jmcabaleiro/syringe-pumpV2/IMG_20181031_165427945.jpg

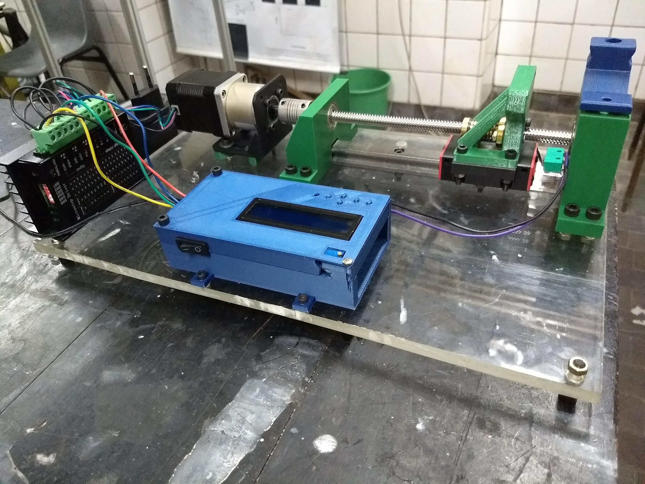
IMG_20181031_165427945.jpg
