jmcabaleiro/syringe-pumpV2/README.md

# syringe-pumpV2
Here you will find solid works parts and assembly to print in a fdm printer, along with the arduino software to control the pump. 
The software was developed by Dr. Eng. Emanuel Elizalde.
