jmcabaleiro/syringe-pumpV2/solid works parts and assembly/608-2Z.sldasm

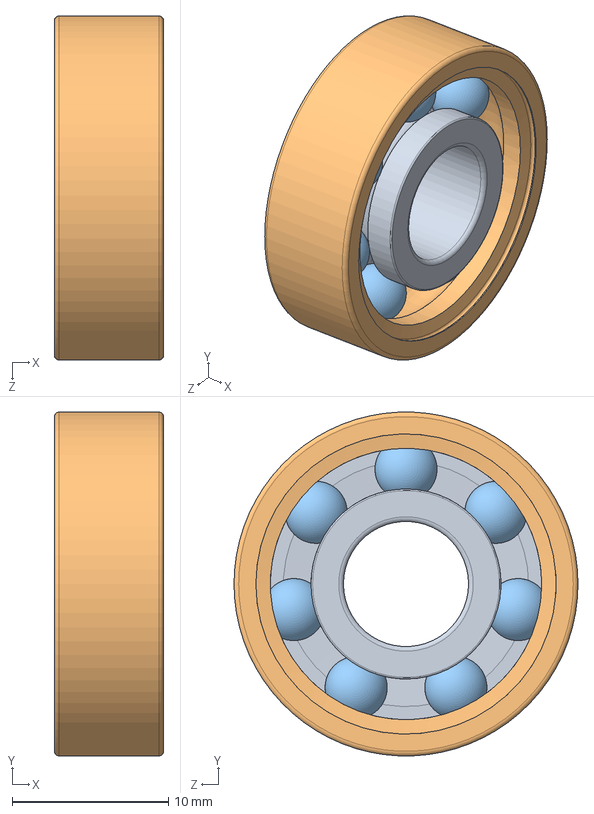
[picture p3: CAD file, 2019-08-21]
solid works parts and assembly/608-2Z.sldasm
7.00 x 22.0 x 22.0 mm
608-2Z_PART1
608-2Z_PART2
608-2Z_PART3 x 7
