jmcabaleiro/syringe-pumpV2/solid works parts and assembly/SW-case arduino syringe pump/arduinocaseTAPAC.SLDPRT

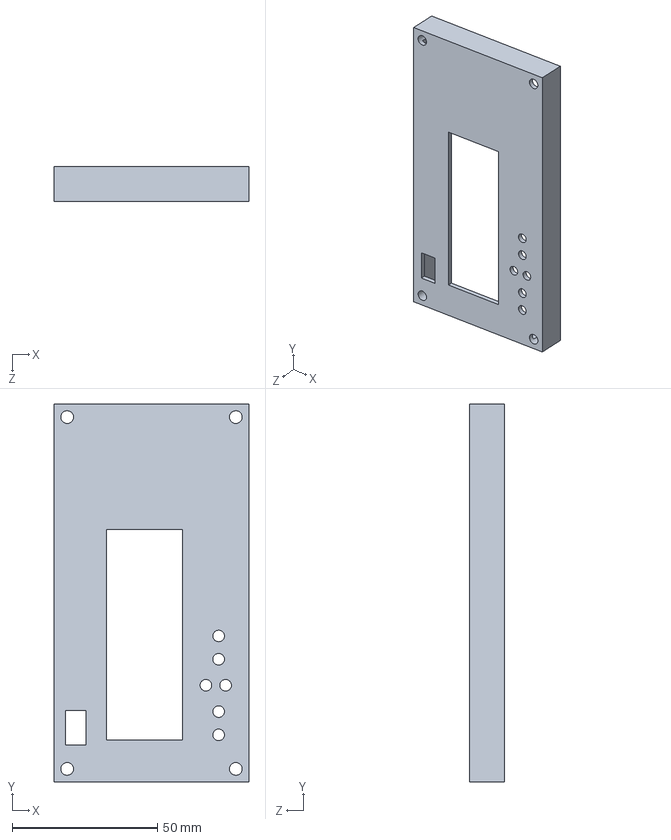
[picture p5: CAD file, 2019-08-21]
solid works parts and assembly/SW-case arduino syringe pump/arduinocaseTAPAC.SLDPRT
67.0 x 130.0 x 12.0 mm
