jmcabaleiro/syringe-pumpV2/solid works parts and assembly/Placa base.SLDPRT

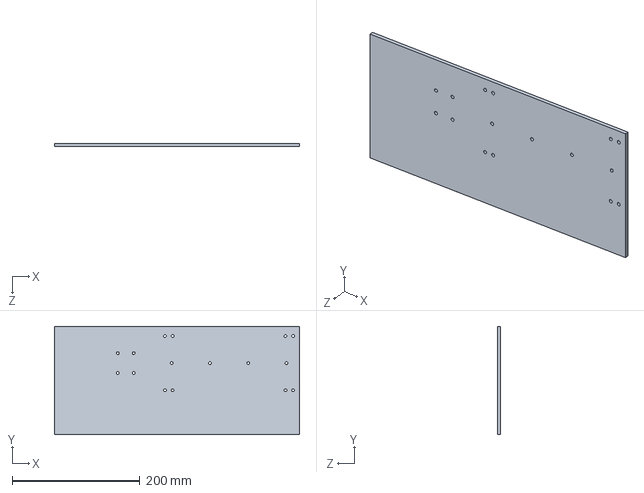
[picture p6: CAD file, 2019-08-21]
solid works parts and assembly/Placa base.SLDPRT
384.2 x 169.5 x 5.00 mm
