jmcabaleiro/syringe-pumpV2/solid works parts and assembly/SW-case arduino syringe pump/arduinocasebaseC.SLDPRT

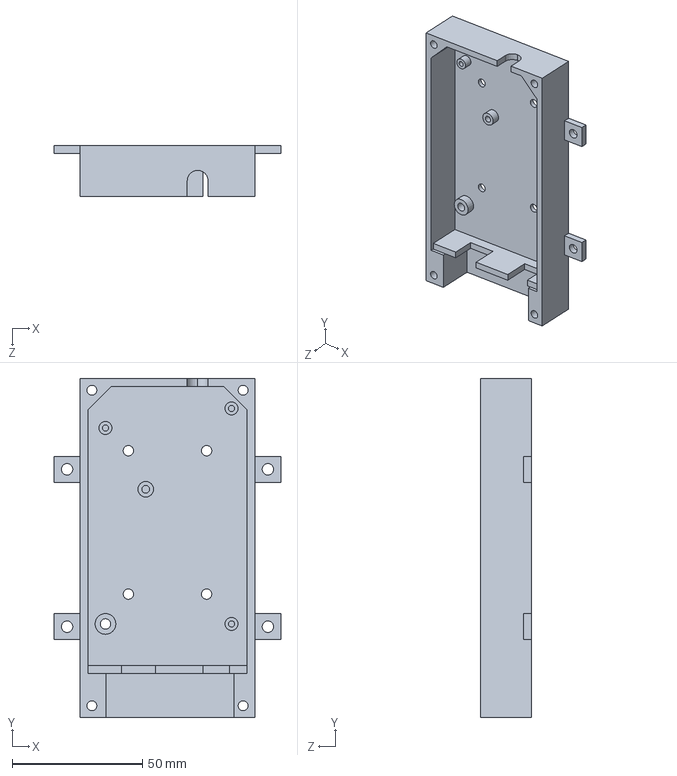
[picture p7: CAD file, 2019-08-21]
solid works parts and assembly/SW-case arduino syringe pump/arduinocasebaseC.SLDPRT
87.0 x 130.0 x 19.5 mm
