jmcabaleiro/syringe-pumpV2/solid works parts and assembly/SW-case arduino syringe pump/boton.SLDPRT

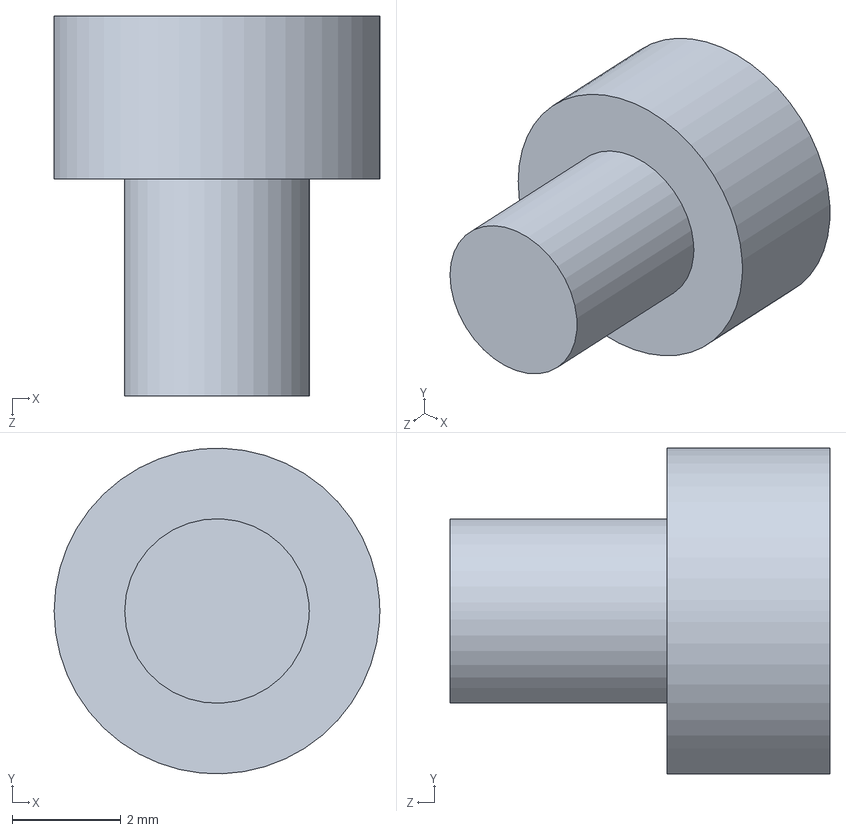
[picture p9: CAD file, 2019-08-21]
solid works parts and assembly/SW-case arduino syringe pump/boton.SLDPRT
6.00 x 6.00 x 7.00 mm
