jmcabaleiro/syringe-pumpV2/solid works parts and assembly/NEMA 17 Motor Mount Plate.SLDPRT

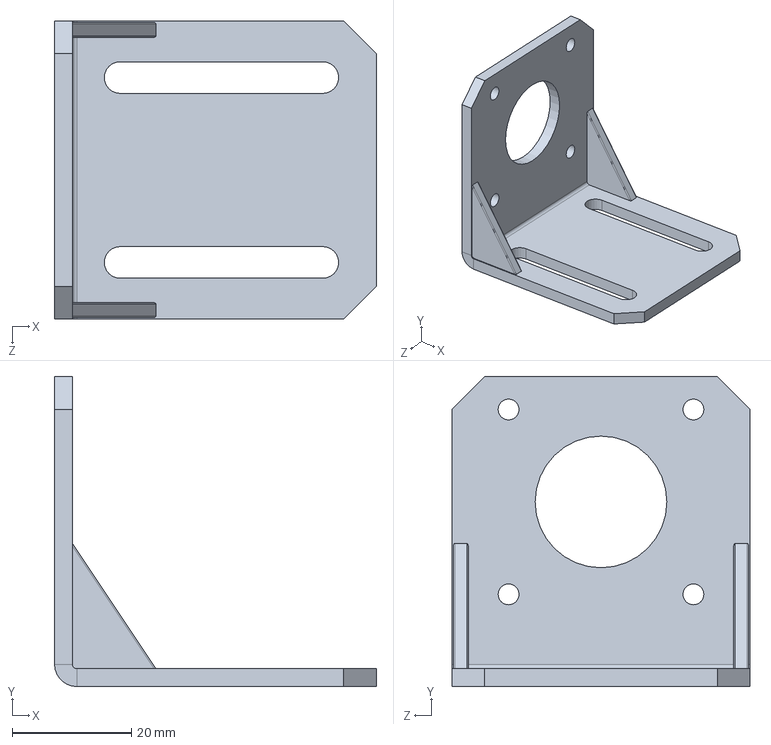
[picture p10: CAD file, 2019-08-21]
solid works parts and assembly/NEMA 17 Motor Mount Plate.SLDPRT
54.0 x 52.0 x 50.0 mm
