jmcabaleiro/syringe-pumpV2/solid works parts and assembly/NEMA17-PG27b.SLDPRT

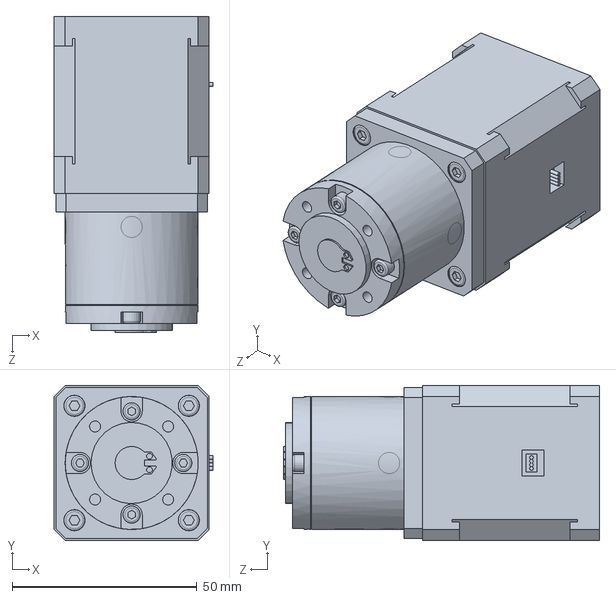
[picture p12: CAD file, 2019-08-21]
solid works parts and assembly/NEMA17-PG27b.SLDPRT
43.0 x 42.0 x 85.6 mm
