jmcabaleiro/syringe-pumpV2/solid works parts and assembly/soporte lado jeringa para impresion.SLDPRT

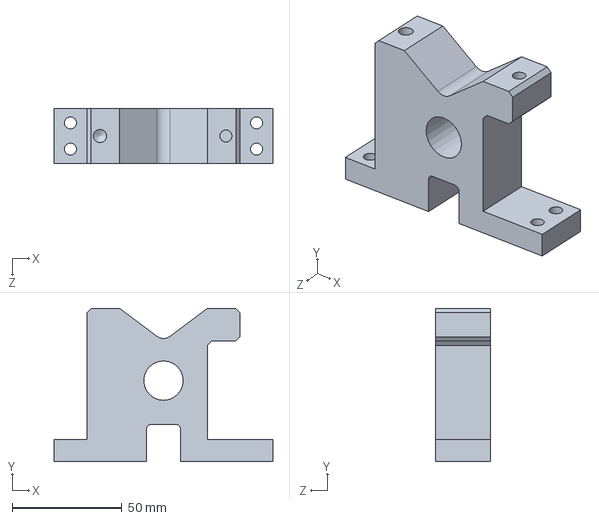
[picture p13: CAD file, 2019-08-21]
solid works parts and assembly/soporte lado jeringa para impresion.SLDPRT
100.0 x 70.0 x 25.0 mm
