jmcabaleiro/syringe-pumpV2/solid works parts and assembly/HGR15T-200mm.SLDPRT

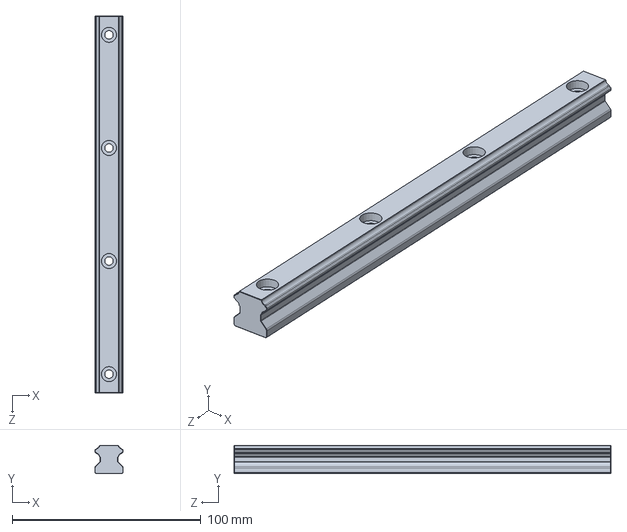
[picture p14: CAD file, 2019-08-21]
solid works parts and assembly/HGR15T-200mm.SLDPRT
15.0 x 15.0 x 200.0 mm
