jmcabaleiro/syringe-pumpV2/solid works parts and assembly/ejereductor.SLDPRT

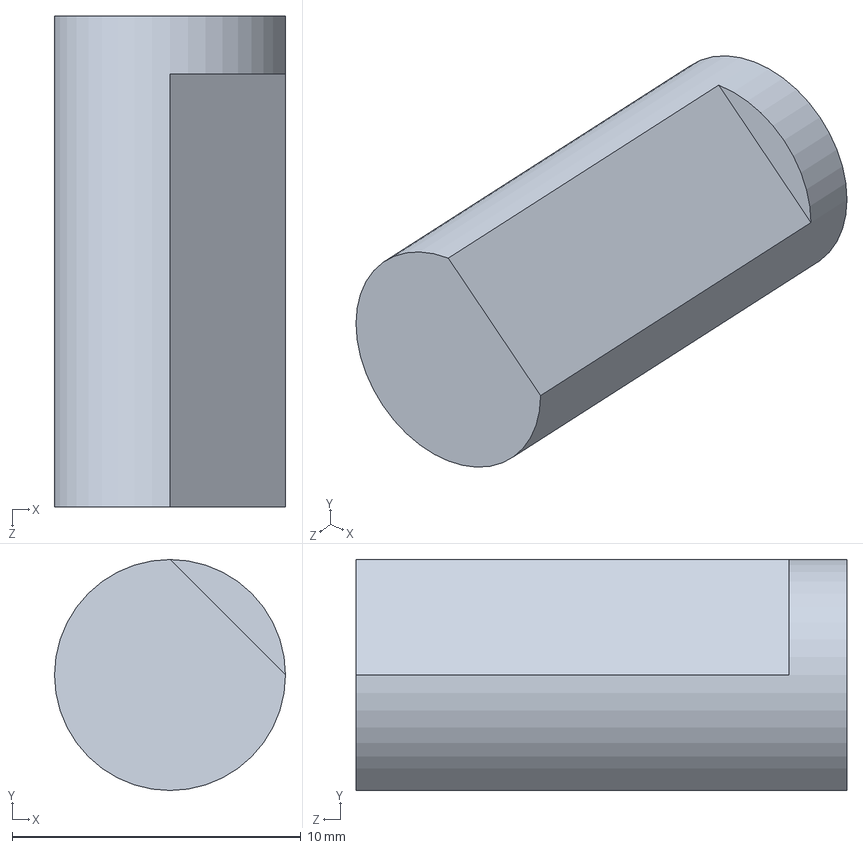
[picture p15: CAD file, 2019-08-21]
solid works parts and assembly/ejereductor.SLDPRT
8.00 x 8.00 x 17.0 mm
