jmcabaleiro/syringe-pumpV2/solid works parts and assembly/soporte lado motor para impresion.SLDPRT

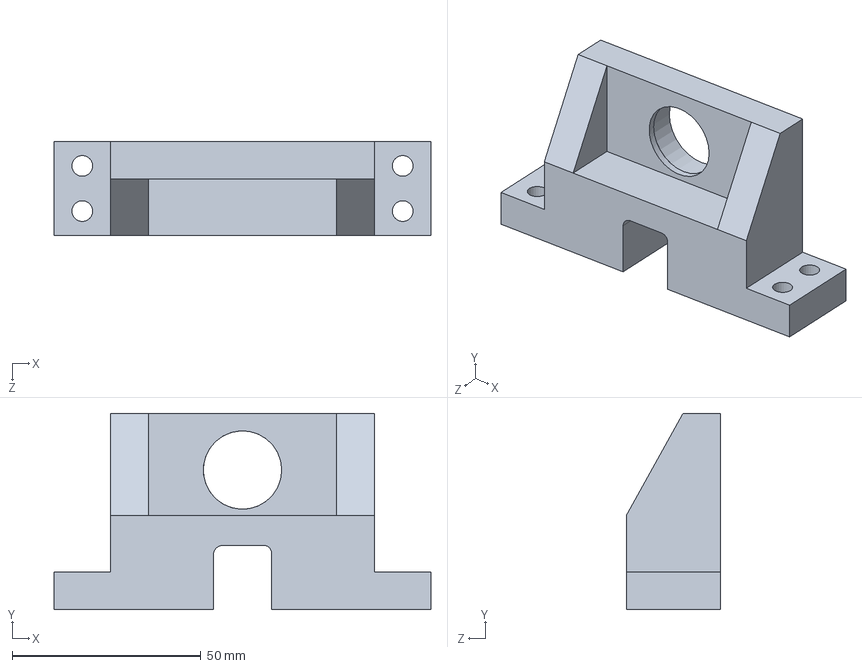
[picture p16: CAD file, 2019-08-21]
solid works parts and assembly/soporte lado motor para impresion.SLDPRT
100.0 x 52.0 x 25.0 mm
