jmcabaleiro/syringe-pumpV2/solid works parts and assembly/base soporte motor.SLDPRT

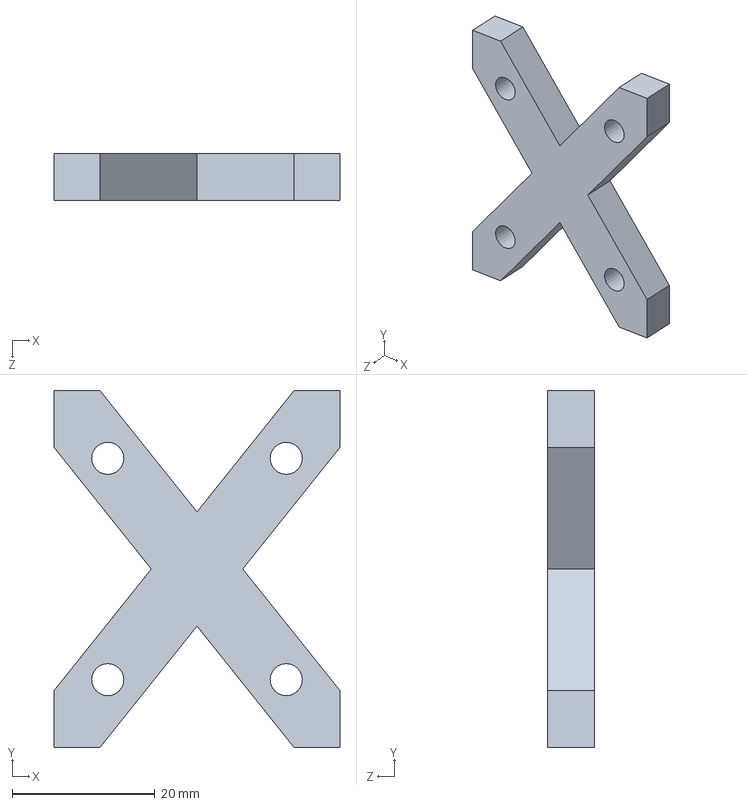
[picture p17: CAD file, 2019-08-21]
solid works parts and assembly/base soporte motor.SLDPRT
40.0 x 50.0 x 6.54 mm
