jmcabaleiro/syringe-pumpV2/solid works parts and assembly/trabajeringa.SLDPRT

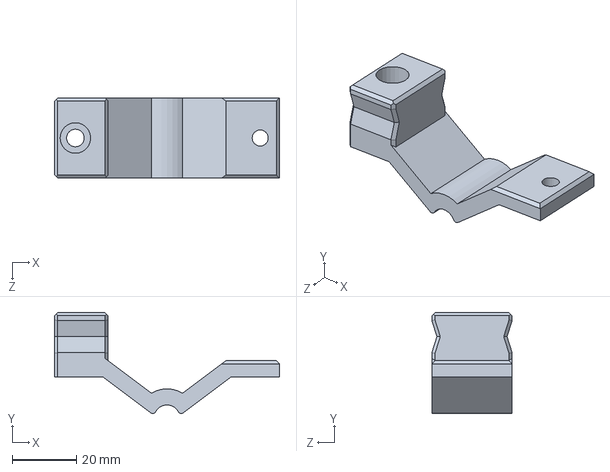
[picture p18: CAD file, 2019-08-21]
solid works parts and assembly/trabajeringa.SLDPRT
70.0 x 31.4 x 25.0 mm
