jmcabaleiro/syringe-pumpV2/solid works parts and assembly/flex coupler5to8mm.SLDPRT

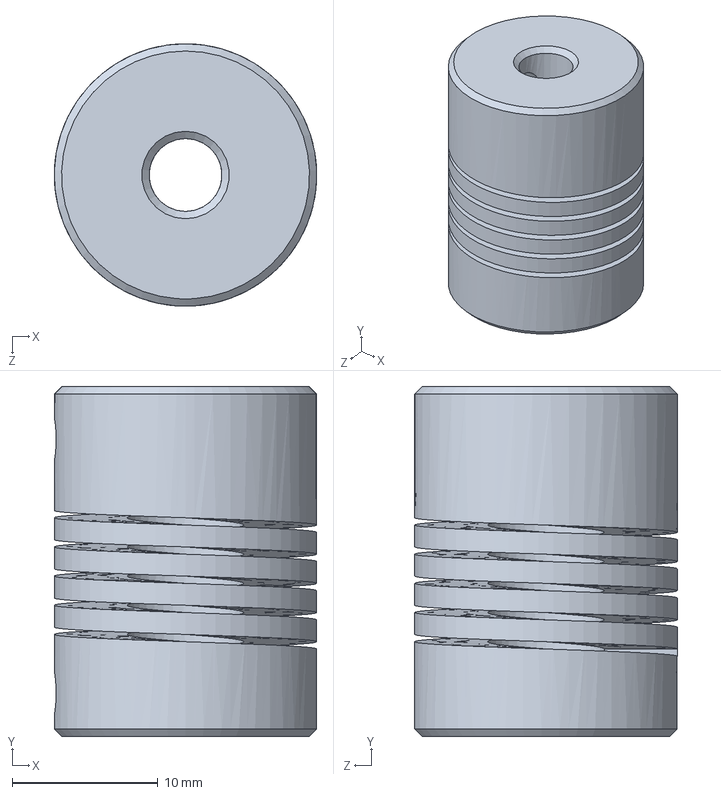
[picture p19: CAD file, 2019-08-21]
solid works parts and assembly/flex coupler5to8mm.SLDPRT
18.0 x 24.0 x 18.0 mm
