jmcabaleiro/syringe-pumpV2/(list of files, cad)

Other CAD files:
solid works parts and assembly/608-2Z.SLDPRT
solid works parts and assembly/Trapezoidal lead screw tr8x8-4-L200mm.SLDPRT
solid works parts and assembly/hexscrewcoupler.SLDPRT
