jmcabaleiro/syringe-pumpV2/solid works parts and assembly/assembly.pdf

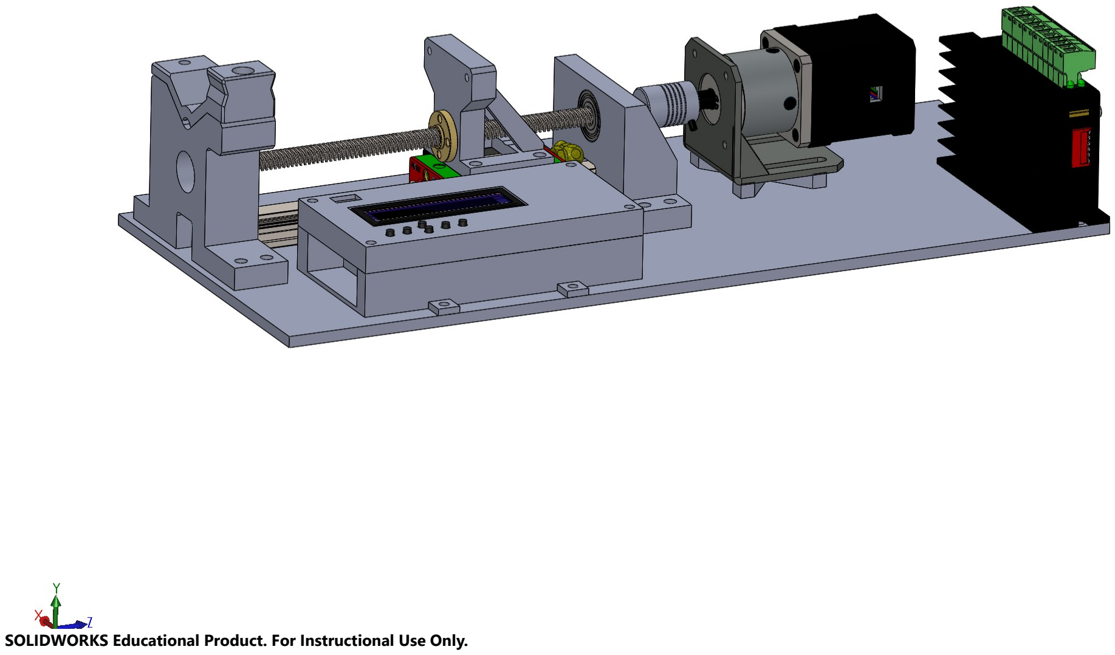
[picture p20: page 1]

SOLIDWORKS Educational Product. For Instructional Use Only.
